lewipewi/esp-32-gaming-console-v2/pcb/emulator_console_v2.kicad_pcb

## KiCad design pcb/emulator_console_v2.kicad_pcb (2026-10-18)

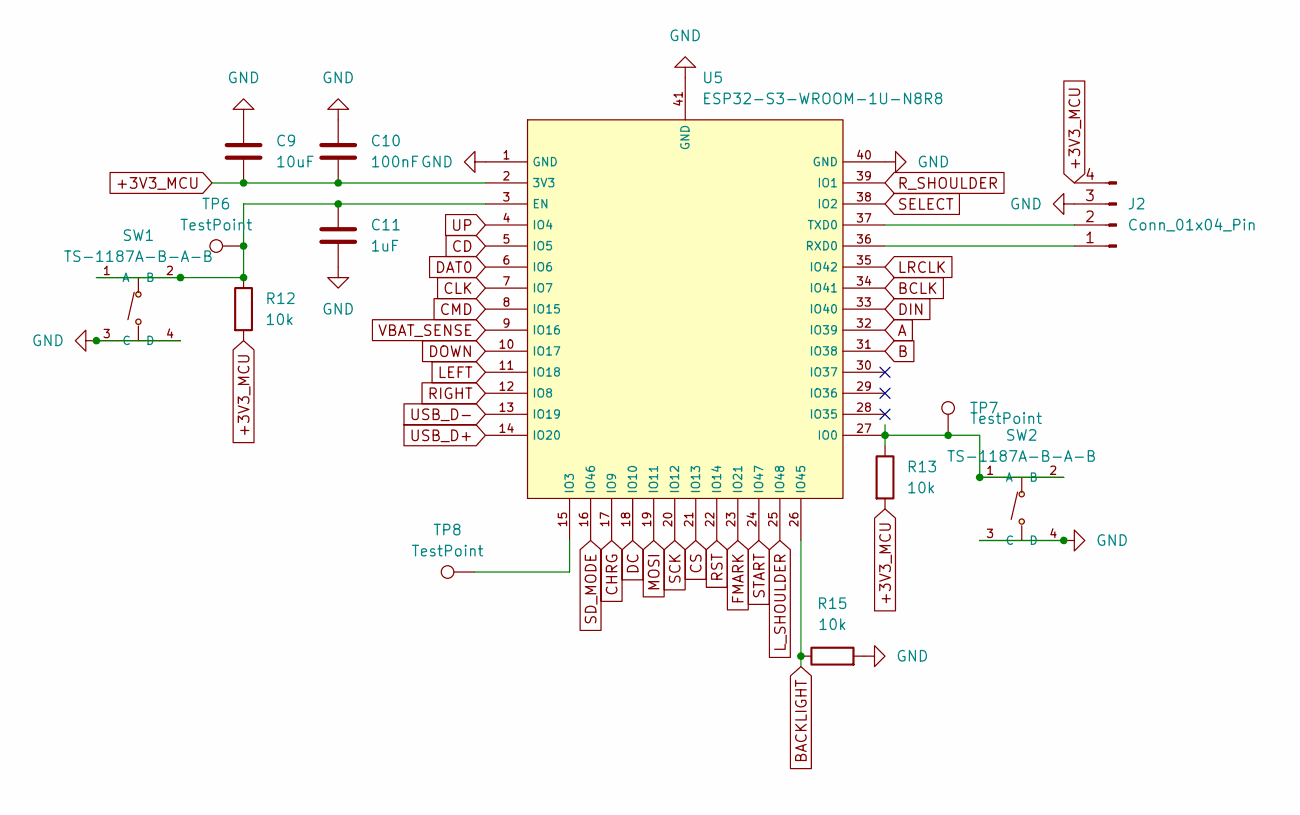
[picture p6: schematic MCU.kicad_sch]

Parts:
C9: 10uF; C_0805_2012Metric_Pad1.18x1.45mm_HandSolder
C10: 100nF; C_0603_1608Metric_Pad1.08x0.95mm_HandSolder
C11: 1uF; C_0603_1608Metric_Pad1.08x0.95mm_HandSolder
J2: Conn_01x04_Pin; PinHeader_1x04_P2.54mm_Vertical
R12, R13, R15: 10k; R_0603_1608Metric_Pad0.98x0.95mm_HandSolder
SW1, SW2: TS-1187A-B-A-B; C318884_SW-SMD_4P-L5_1-W5_1-P3_70-LS6_5-TL_H1_5; LCSC C318884
TP6, TP7, TP8: TestPoint; TestPoint_Pad_2.0x2.0mm
U5: ESP32-S3-WROOM-1U-N8R8; C2980300_WIRELM-SMD_ESP32-S3-WROOM-1U; LCSC C2980300

Connections:
+3V3_MCU: C9.2, C10.2, J2.4, R12.2, R13.2, U5.2 (3V3); also elsewhere on the board
A: U5.32 (IO39); also elsewhere on the board
B: U5.31 (IO38); also elsewhere on the board
BACKLIGHT: R15.1, U5.26 (IO45); also elsewhere on the board
BCLK: U5.34 (IO41); also elsewhere on the board
CD: U5.5 (IO5); also elsewhere on the board
CHRG: U5.17 (IO9); also elsewhere on the board
CLK: U5.7 (IO7); also elsewhere on the board
CMD: U5.8 (IO15); also elsewhere on the board
CS: U5.21 (IO13); also elsewhere on the board
DAT0: U5.6 (IO6); also elsewhere on the board
DC: U5.18 (IO10); also elsewhere on the board
DIN: U5.33 (IO40); also elsewhere on the board
DOWN: U5.10 (IO17); also elsewhere on the board
FMARK: U5.23 (IO21); also elsewhere on the board
GND: C9.1, C10.1, C11.2, J2.3, R15.2, SW1.3 (C), SW1.4 (D), SW2.3 (C), SW2.4 (D), U5.1 (GND), U5.40 (GND), U5.41 (GND); also elsewhere on the board
LEFT: U5.11 (IO18); also elsewhere on the board
LRCLK: U5.35 (IO42); also elsewhere on the board
L_SHOULDER: U5.25 (IO48); also elsewhere on the board
MOSI: U5.19 (IO11); also elsewhere on the board
unnamed: J2.1, U5.36 (RXD0)
unnamed: J2.2, U5.37 (TXD0)
unnamed: C11.1, R12.1, SW1.1 (A), SW1.2 (B), TP6.1 (1_1), U5.3 (EN)
unnamed: R13.1, SW2.1 (A), SW2.2 (B), TP7.1 (1_1), U5.27 (IO0)
unnamed: TP8.1 (1_1), U5.15 (IO3)
RIGHT: U5.12 (IO8); also elsewhere on the board
RST: U5.22 (IO14); also elsewhere on the board
R_SHOULDER: U5.39 (IO1); also elsewhere on the board
SCK: U5.20 (IO12); also elsewhere on the board
SD_MODE: U5.16 (IO46); also elsewhere on the board
SELECT: U5.38 (IO2); also elsewhere on the board
START: U5.24 (IO47); also elsewhere on the board
UP: U5.4 (IO4); also elsewhere on the board
USB_D+: U5.14 (IO20); also elsewhere on the board
USB_D-: U5.13 (IO19); also elsewhere on the board
VBAT_SENSE: U5.9 (IO16); also elsewhere on the board

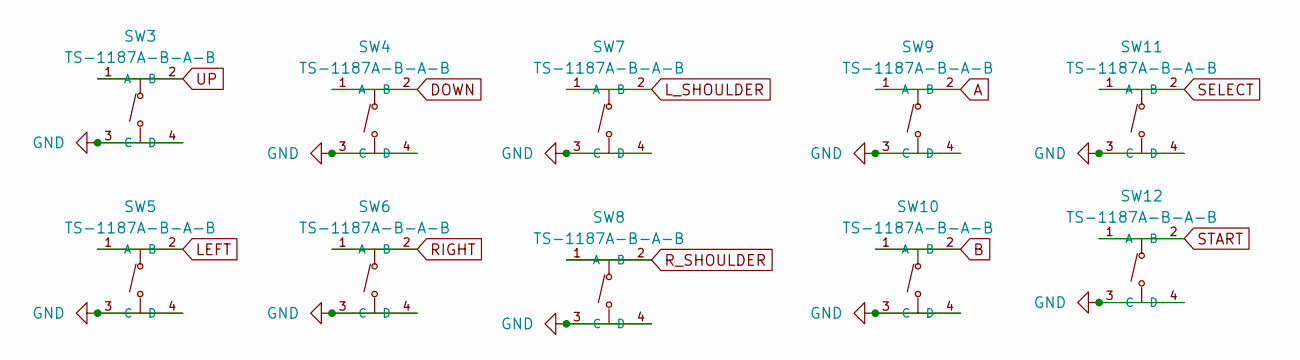
[picture p7: schematic BUTTONs.kicad_sch]

Parts:
SW3, SW4, SW5, SW6, SW7, SW8, SW9, SW10, SW11, SW12: TS-1187A-B-A-B; C318884_SW-SMD_4P-L5_1-W5_1-P3_70-LS6_5-TL_H1_5; LCSC C318884

Connections:
A: SW9.1 (A), SW9.2 (B); also elsewhere on the board
B: SW10.1 (A), SW10.2 (B); also elsewhere on the board
DOWN: SW4.1 (A), SW4.2 (B); also elsewhere on the board
GND: SW3.3 (C), SW3.4 (D), SW4.3 (C), SW4.4 (D), SW5.3 (C), SW5.4 (D), SW6.3 (C), SW6.4 (D), SW7.3 (C), SW7.4 (D), SW8.3 (C), SW8.4 (D), SW9.3 (C), SW9.4 (D), SW10.3 (C), SW10.4 (D), SW11.3 (C), SW11.4 (D), SW12.3 (C), SW12.4 (D); also elsewhere on the board
LEFT: SW5.1 (A), SW5.2 (B); also elsewhere on the board
L_SHOULDER: SW7.1 (A), SW7.2 (B); also elsewhere on the board
RIGHT: SW6.1 (A), SW6.2 (B); also elsewhere on the board
R_SHOULDER: SW8.1 (A), SW8.2 (B); also elsewhere on the board
SELECT: SW11.1 (A), SW11.2 (B); also elsewhere on the board
START: SW12.1 (A), SW12.2 (B); also elsewhere on the board
UP: SW3.1 (A), SW3.2 (B); also elsewhere on the board

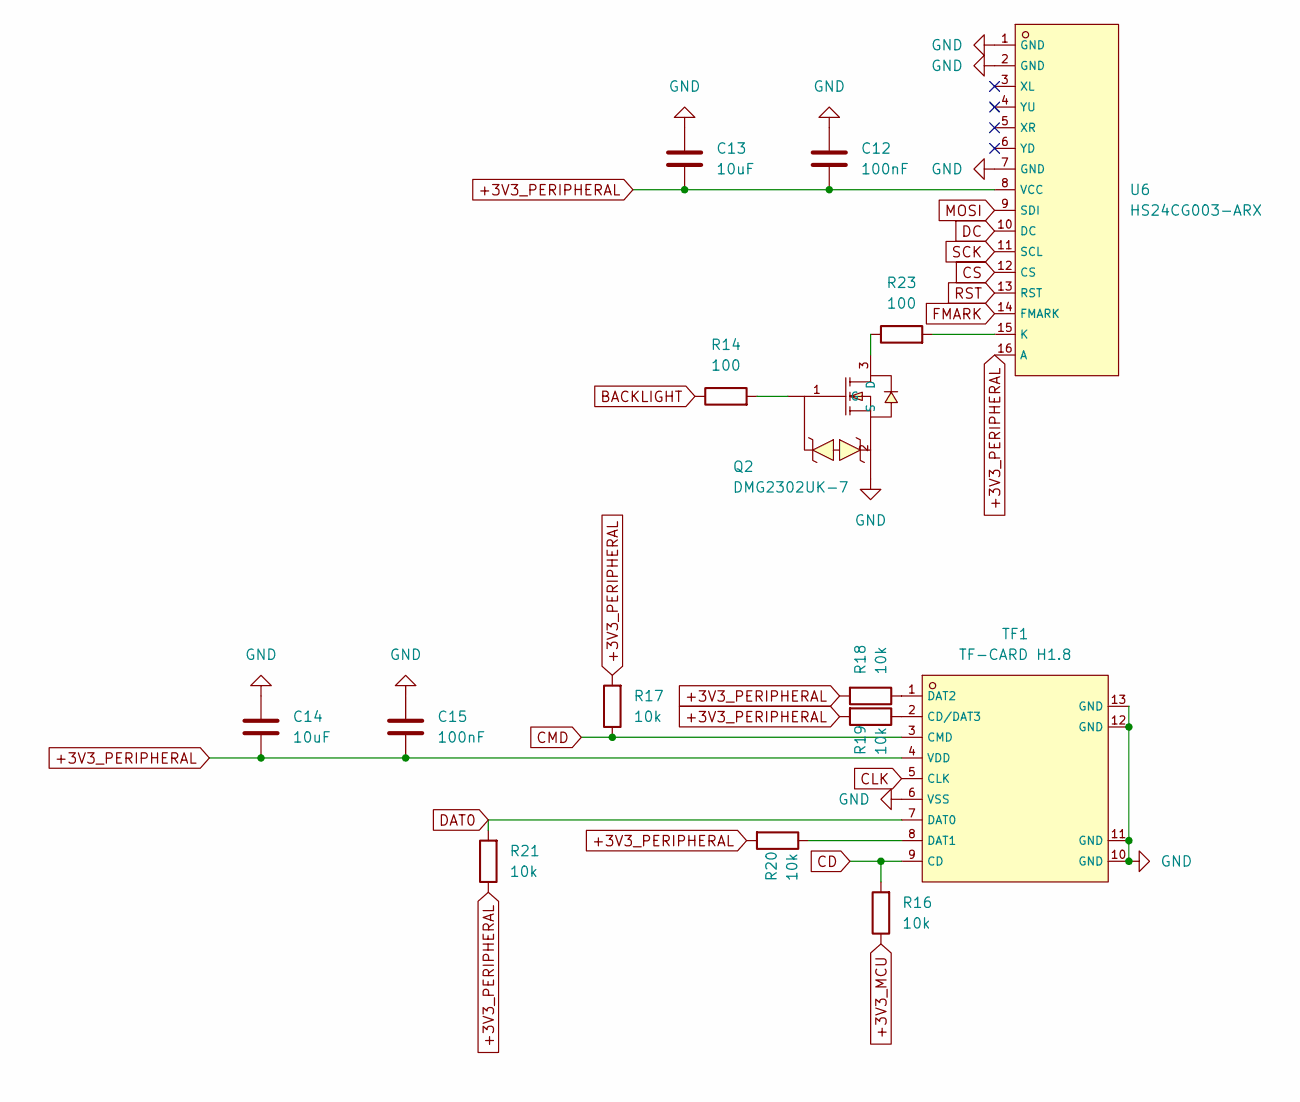
[picture p8: schematic display_storage.kicad_sch]

Parts:
C12, C15: 100nF; C_0603_1608Metric_Pad1.08x0.95mm_HandSolder
C13, C14: 10uF; C_0805_2012Metric_Pad1.18x1.45mm_HandSolder
Q2: DMG2302UK-7; C460977_SOT-23-3_L2_9-W1_3-P1_90-LS2_4-BR; LCSC C460977
R14, R23: 100; R_0603_1608Metric_Pad0.98x0.95mm_HandSolder
R16, R17, R18, R19, R20, R21: 10k; R_0603_1608Metric_Pad0.98x0.95mm_HandSolder
TF1: TF-CARD H1.8; C7529389_TF-SMD_TF-CARD-H1_8; LCSC C7529389
U6: HS24CG003-ARX; HS24CG003_SideWrap_W70; LCSC C5329583

Connections:
+3V3_MCU: R16.1; also elsewhere on the board
+3V3_PERIPHERAL: C12.2, C13.2, C14.2, C15.2, R17.2, R18.2, R19.2, R20.2, R21.1, TF1.4 (VDD), U6.8 (VCC), U6.16 (A); also elsewhere on the board
BACKLIGHT: R14.1; also elsewhere on the board
CD: R16.2, TF1.9 (CD); also elsewhere on the board
CLK: TF1.5 (CLK); also elsewhere on the board
CMD: R17.1, TF1.3 (CMD); also elsewhere on the board
CS: U6.12 (CS); also elsewhere on the board
DAT0: R21.2, TF1.7 (DAT0); also elsewhere on the board
DC: U6.10 (DC); also elsewhere on the board
FMARK: U6.14 (FMARK); also elsewhere on the board
GND: C12.1, C13.1, C14.1, C15.1, Q2.2 (S), TF1.6 (VSS), TF1.10 (GND), TF1.11 (GND), TF1.12 (GND), TF1.13 (GND), U6.1 (GND), U6.2 (GND), U6.7 (GND); also elsewhere on the board
MOSI: U6.9 (SDI); also elsewhere on the board
unnamed: Q2.3 (D), R23.1
unnamed: Q2.1 (G), R14.2
unnamed: R19.1, TF1.2 (CD/DAT3)
unnamed: R20.1, TF1.8 (DAT1)
unnamed: R18.1, TF1.1 (DAT2)
unnamed: R23.2, U6.15 (K)
RST: U6.13 (RST); also elsewhere on the board
SCK: U6.11 (SCL); also elsewhere on the board

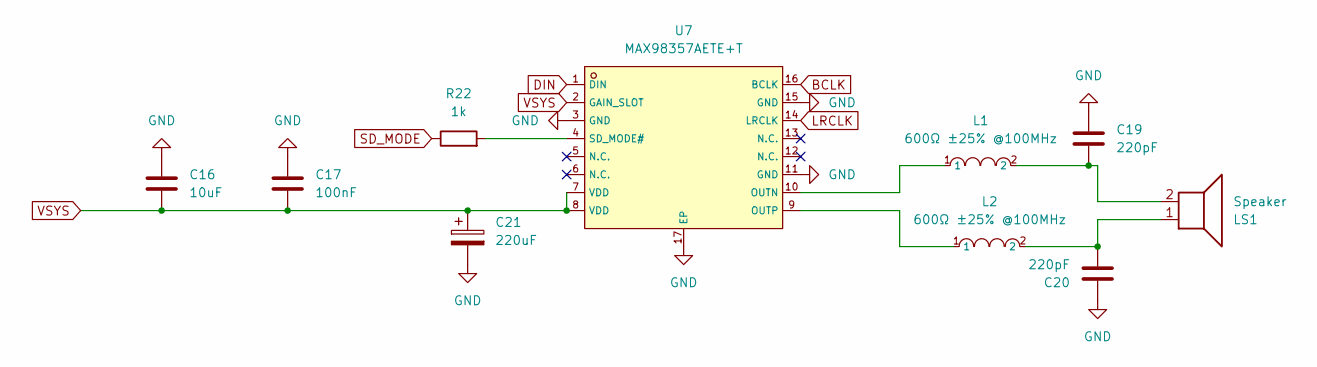
[picture p9: schematic AUDIO.kicad_sch]

Parts:
C16: 10uF; C_0805_2012Metric_Pad1.18x1.45mm_HandSolder
C17: 100nF; C_0603_1608Metric_Pad1.08x0.95mm_HandSolder
C19, C20: 220pF; C_0603_1608Metric_Pad1.08x0.95mm_HandSolder
C21: 220uF; CP_Radial_D6.3mm_P2.50mm
L1, L2: 600Ω ±25% @100MHz; C21519_L0805; LCSC C21519
LS1: Speaker; SolderWire-0.15sqmm_1x02_P4mm_D0.5mm_OD1.5mm_Relief
R22: 1k; R_0603_1608Metric_Pad0.98x0.95mm_HandSolder
U7: MAX98357AETE+T; C910544_TQFN-16_L3_0-W3_0-P0_50-BL-EP1_5; LCSC C910544

Connections:
BCLK: U7.16 (BCLK); also elsewhere on the board
DIN: U7.1 (DIN); also elsewhere on the board
GND: C16.1, C17.1, C19.1, C20.1, C21.2, U7.3 (GND), U7.11 (GND), U7.15 (GND), U7.17 (EP); also elsewhere on the board
LRCLK: U7.14 (LRCLK); also elsewhere on the board
unnamed: C19.2, L1.2, LS1.2
unnamed: C20.2, L2.2, LS1.1
unnamed: L1.1, U7.10 (OUTN)
unnamed: L2.1, U7.9 (OUTP)
unnamed: R22.2, U7.4 (SD_MODE#)
SD_MODE: R22.1; also elsewhere on the board
VSYS: C16.2, C17.2, C21.1, U7.2 (GAIN_SLOT), U7.7 (VDD), U7.8 (VDD); also elsewhere on the board

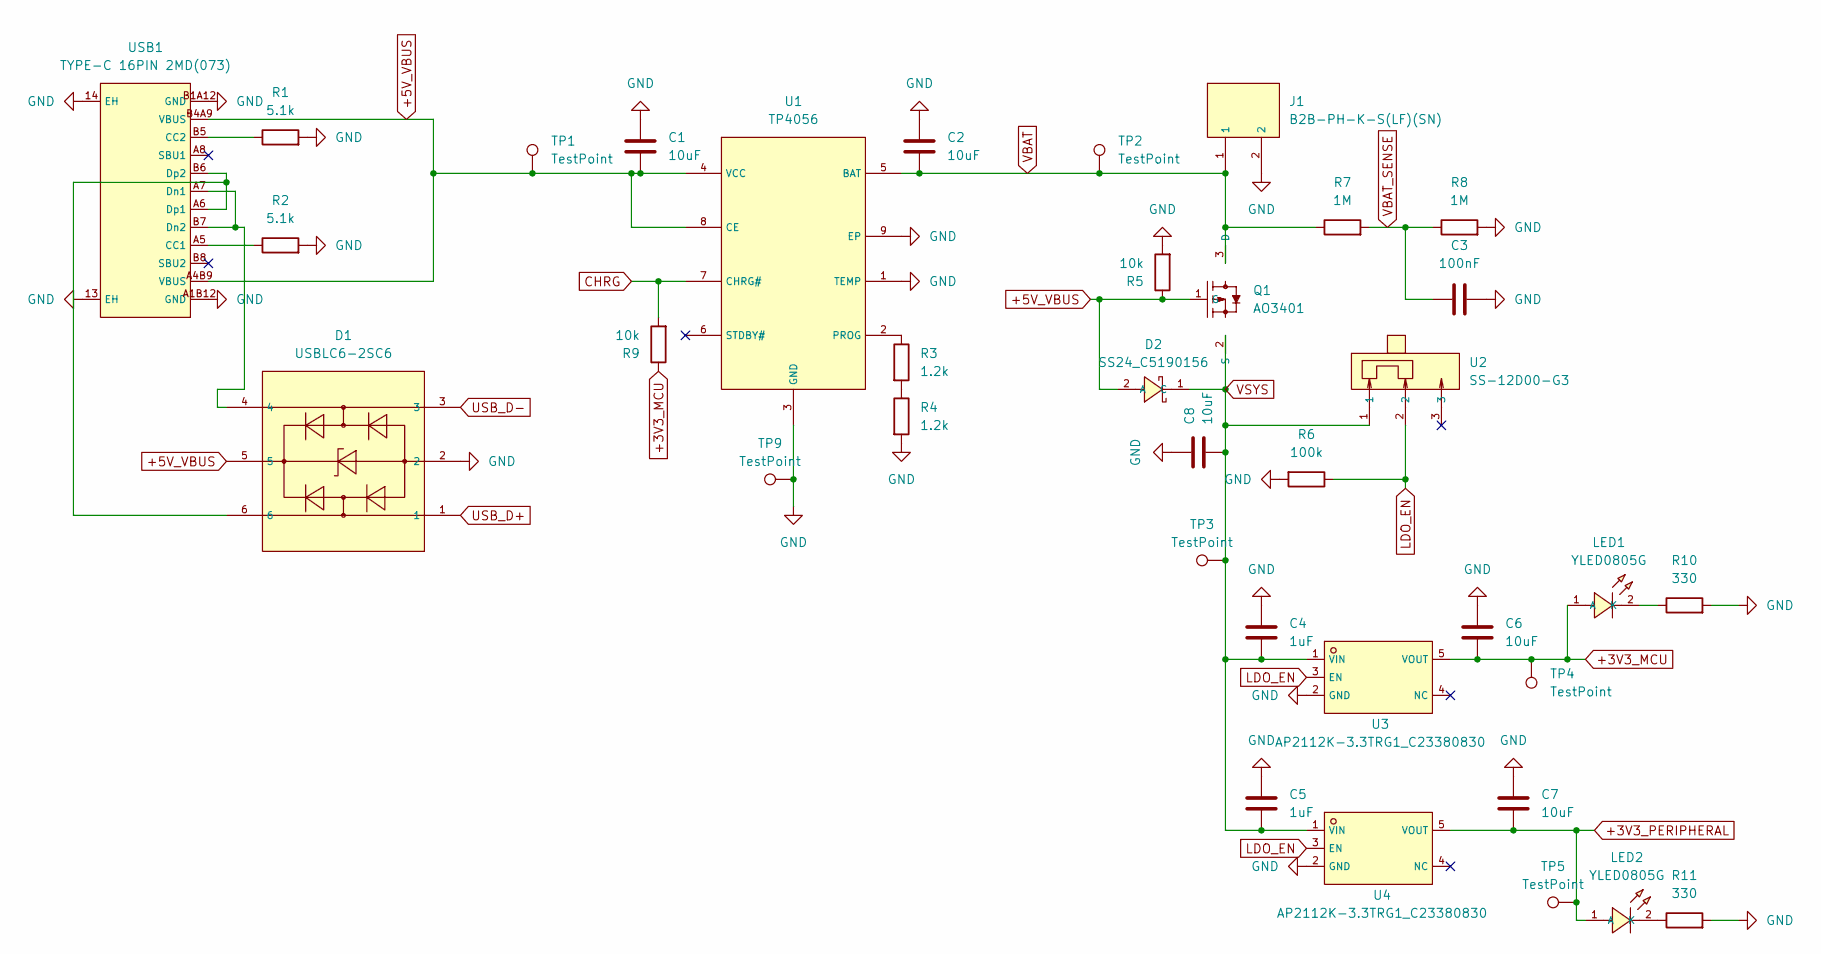
[picture p10: schematic POWER.kicad_sch]

Parts:
C1, C2, C6, C7, C8: 10uF; C_0805_2012Metric_Pad1.18x1.45mm_HandSolder
C3: 100nF; C_0603_1608Metric_Pad1.08x0.95mm_HandSolder
C4, C5: 1uF; C_0603_1608Metric_Pad1.08x0.95mm_HandSolder
D1: USBLC6-2SC6; C7519_SOT-23-6_L2_9-W1_6-P0_95-LS2_8-BL; LCSC C7519
D2: SS24_C5190156; C5190156_SMB_L4_3-W3_6-LS5_4-RD; LCSC C5190156
J1: B2B-PH-K-S(LF)(SN); C131337_CONN-TH_B2B-PH-K-S; LCSC C131337
LED1, LED2: YLED0805G; C25170728_LED0805-FD-GREEN; LCSC C25170728
Q1: AO3401; C181091_SOT-23-3_L2_9-W1_3-P1_90-LS2_4-BR; LCSC C181091
R1, R2: 5.1k; R_0603_1608Metric_Pad0.98x0.95mm_HandSolder
R3, R4: 1.2k; R_0603_1608Metric_Pad0.98x0.95mm_HandSolder
R5, R9: 10k; R_0603_1608Metric_Pad0.98x0.95mm_HandSolder
R6: 100k; R_0603_1608Metric_Pad0.98x0.95mm_HandSolder
R7, R8: 1M; R_0603_1608Metric_Pad0.98x0.95mm_HandSolder
R10, R11: 330; R_0603_1608Metric_Pad0.98x0.95mm_HandSolder
TP1, TP2, TP3, TP4, TP5, TP9: TestPoint; TestPoint_Pad_2.0x2.0mm
U1: TP4056; C16581_ESOP-8_L4_9-W3_9-P1_27-LS6_0-BL-EP; LCSC C16581
U2: SS-12D00-G3; C22355741_SW-TH_3P-L8_8-W3_9-P2_50_SS12D00G3; LCSC C22355741
U3, U4: AP2112K-3.3TRG1_C23380830; C23380830_SOT-23-5_L2_9-W1_6-P0_95-LS2_8-BR; LCSC C23380830
USB1: TYPE-C 16PIN 2MD(073); C2765186_USB-C-SMD_TYPE-C-16PIN-2MD-073; LCSC C2765186

Connections:
+3V3_MCU: C6.2, LED1.1 (A), R9.1, TP4.1 (1_1), U3.5 (VOUT); also elsewhere on the board
+3V3_PERIPHERAL: C7.2, LED2.1 (A), TP5.1 (1_1), U4.5 (VOUT); also elsewhere on the board
+5V_VBUS: C1.2, D1.5, D2.2 (A), Q1.1 (G), R5.1, TP1.1 (1_1), U1.4 (VCC), U1.8 (CE), USB1.A4B9 (VBUS), USB1.B4A9 (VBUS)
CHRG: R9.2, U1.7 (CHRG#); also elsewhere on the board
GND: C1.1, C2.1, C3.2, C4.1, C5.1, C6.1, C7.1, C8.1, D1.2, J1.2, R1.2, R2.2, R4.2, R5.2, R6.2, R8.2, R10.2, R11.2, TP9.1 (1_1), U1.1 (TEMP), U1.3 (GND), U1.9 (EP), U3.2 (GND), U4.2 (GND), USB1.13 (EH), USB1.14 (EH), USB1.A1B12 (GND), USB1.B1A12 (GND); also elsewhere on the board
LDO_EN: R6.1, U2.2, U3.3 (EN), U4.3 (EN)
unnamed: LED1.2 (K), R10.1
unnamed: LED2.2 (K), R11.1
unnamed: R3.2, R4.1
unnamed: R3.1, U1.2 (PROG)
unnamed: R2.1, USB1.A5 (CC1)
unnamed: R1.1, USB1.B5 (CC2)
unnamed: D1.4, USB1.A7 (Dn1), USB1.B7 (Dn2)
unnamed: D1.6, USB1.A6 (Dp1), USB1.B6 (Dp2)
USB_D+: D1.1; also elsewhere on the board
USB_D-: D1.3; also elsewhere on the board
VBAT: C2.2, J1.1, Q1.3 (D), R7.1, TP2.1 (1_1), U1.5 (BAT)
VBAT_SENSE: C3.1, R7.2, R8.1; also elsewhere on the board
VSYS: C4.2, C5.2, C8.2, D2.1 (C), Q1.2 (S), TP3.1 (1_1), U2.1, U3.1 (VIN), U4.1 (VIN); also elsewhere on the board

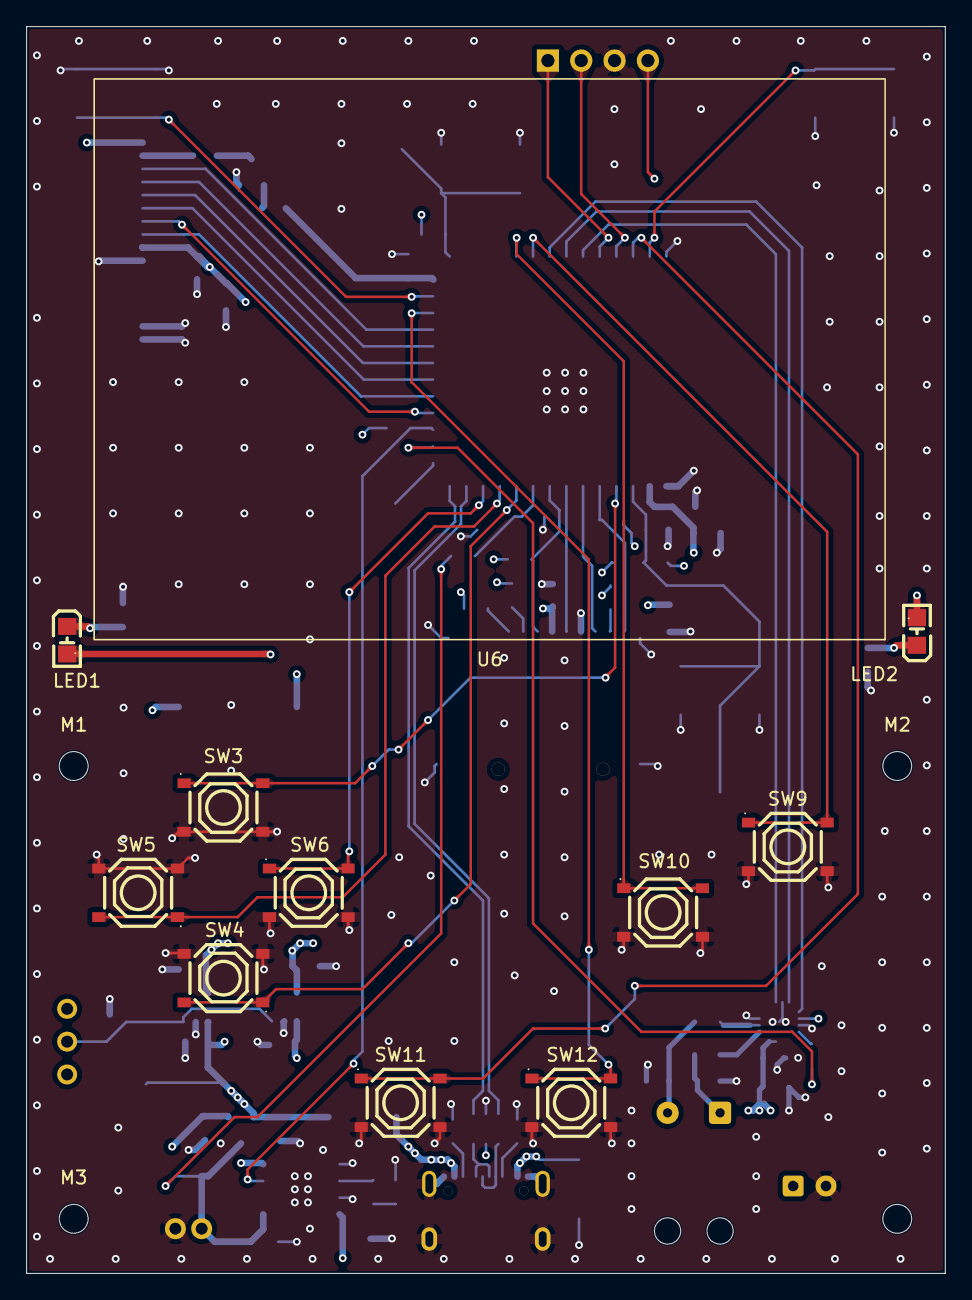
[picture p11: board emulator_console_v2.kicad_pcb from above]

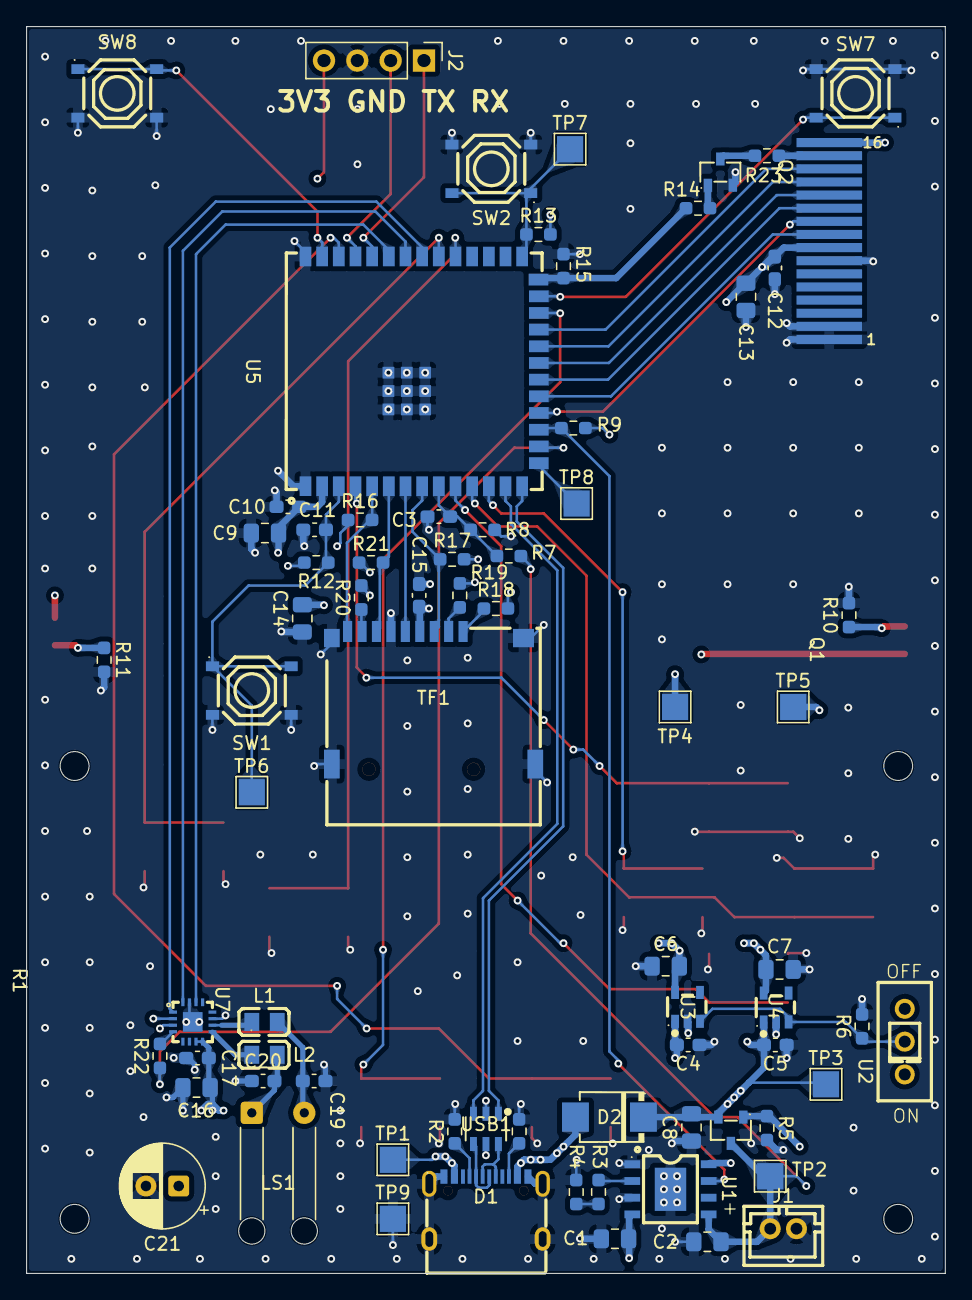
[picture p12: board emulator_console_v2.kicad_pcb from below]

Board: 4 copper layers, 70.0 x 95.0 mm, 88 parts (73 on the bottom side), 60 nets.

Other parts of the board:
M1, M2, M3, M4: MountingHole_2.2mm_M2
